hariharanboss/VEGA-Sentinel/images/README.md

# images/

Real photographs and diagrams of the project.

| Folder | Intended contents |
|---|---|
| `prototype/` | photos of the wired ARIES v2.0 build (sensors, divider, buzzer driver) |
| `architecture/` | rendered system/architecture diagrams |
| `testing/` | photos/videos-stills of trials (controlled, supervised flame tests etc.) |

**No images are committed yet** — add real photos here; do not commit
placeholder or stock images. Mermaid diagrams in README.md/docs render on
GitHub and are the current architecture visuals.
