hariharanboss/VEGA-Sentinel/docs/report/vega_sentinel_flame_incident.pdf

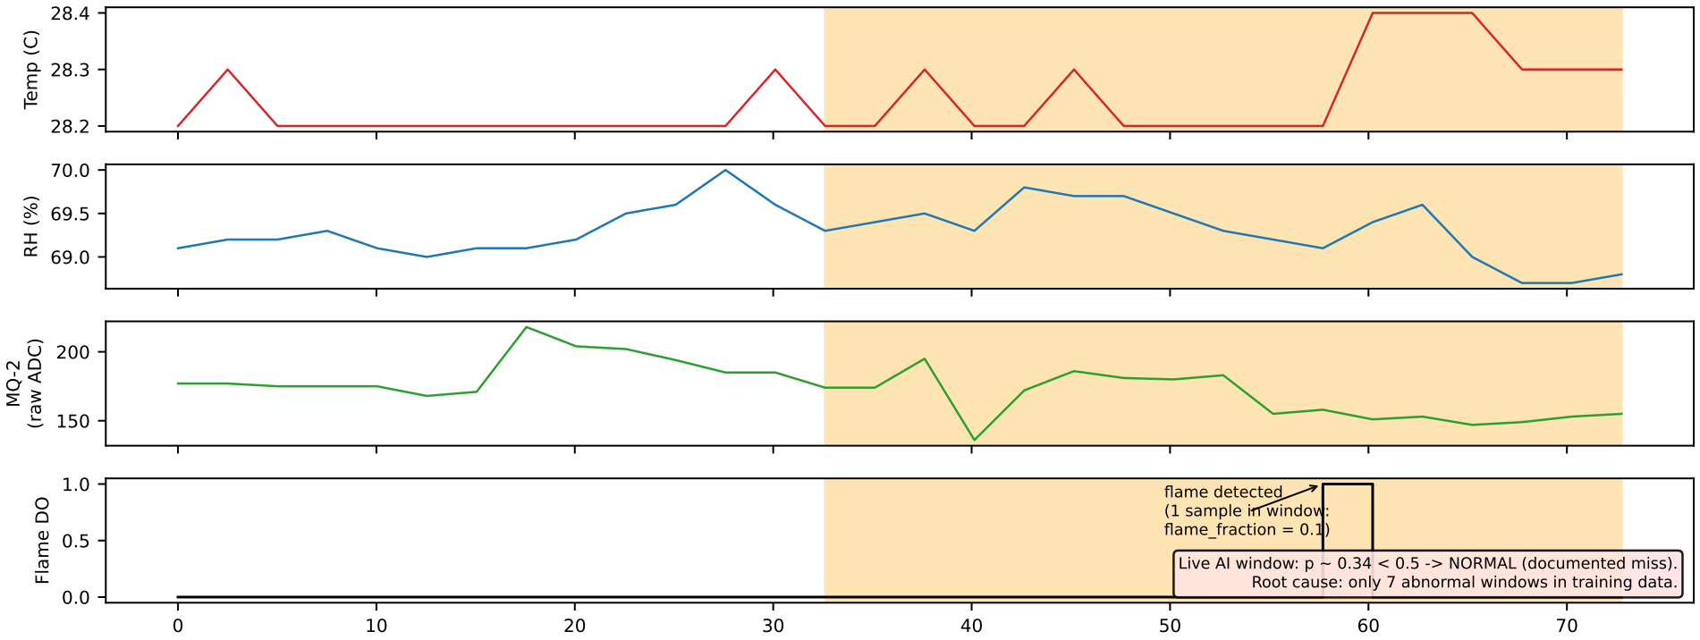
[picture p1: figure]
Temp (C); (raw ADC); Flame DO; flame detected; (1 sample in window: flame_fraction = 0.1)

## Time since session start (s)

Live AI window: p ~ 0.34 < 0.5 -> NORMAL (documented miss). Root cause: only 7 abnormal windows in training data.

## Flame trial 2026-09-11 19:03 (session sentinel_data_20260911_190322)
