hariharanboss/VEGA-Sentinel/docs/report/vega_sentinel_flame_incident.png

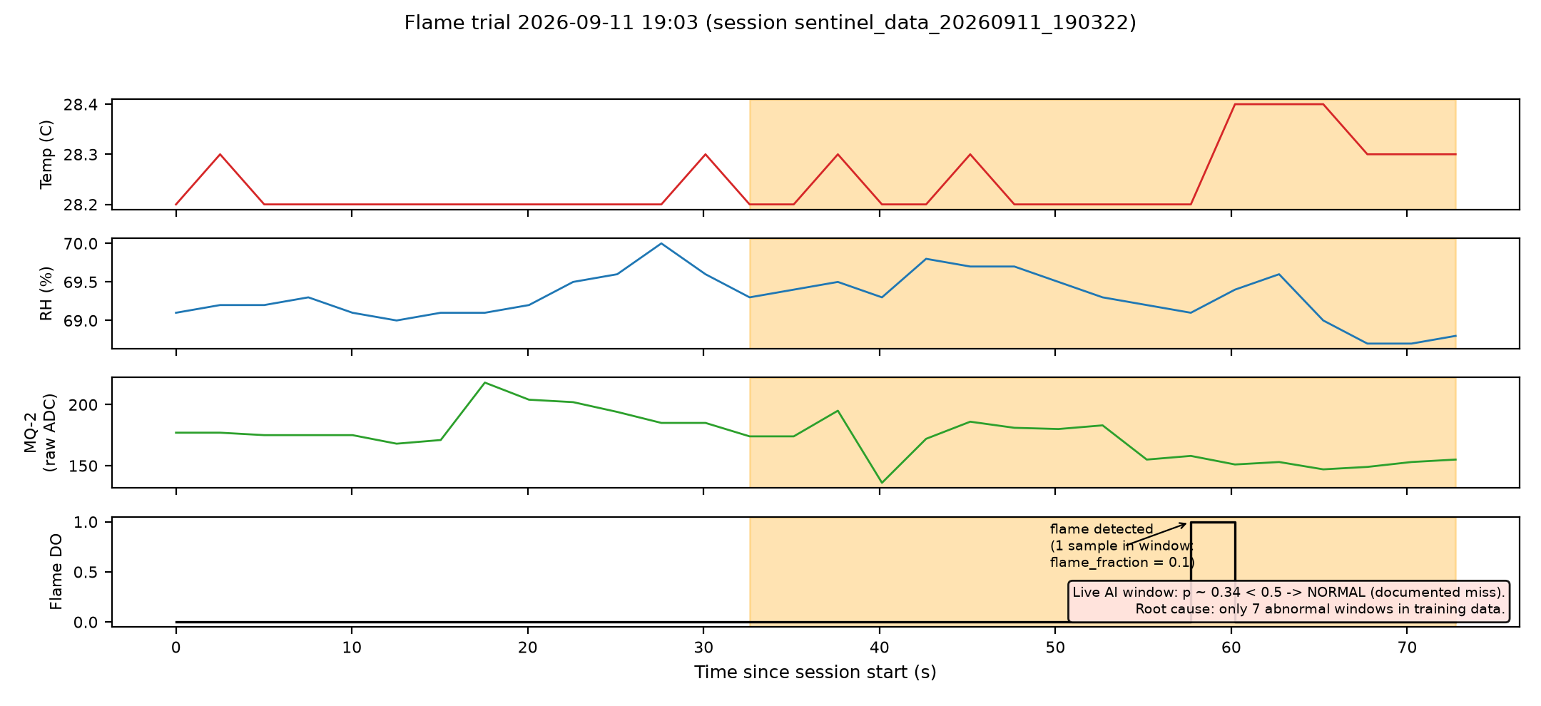
docs/report/vega_sentinel_flame_incident.png
