hariharanboss/VEGA-Sentinel/docs/report/vega_sentinel_mq2_comparison.png

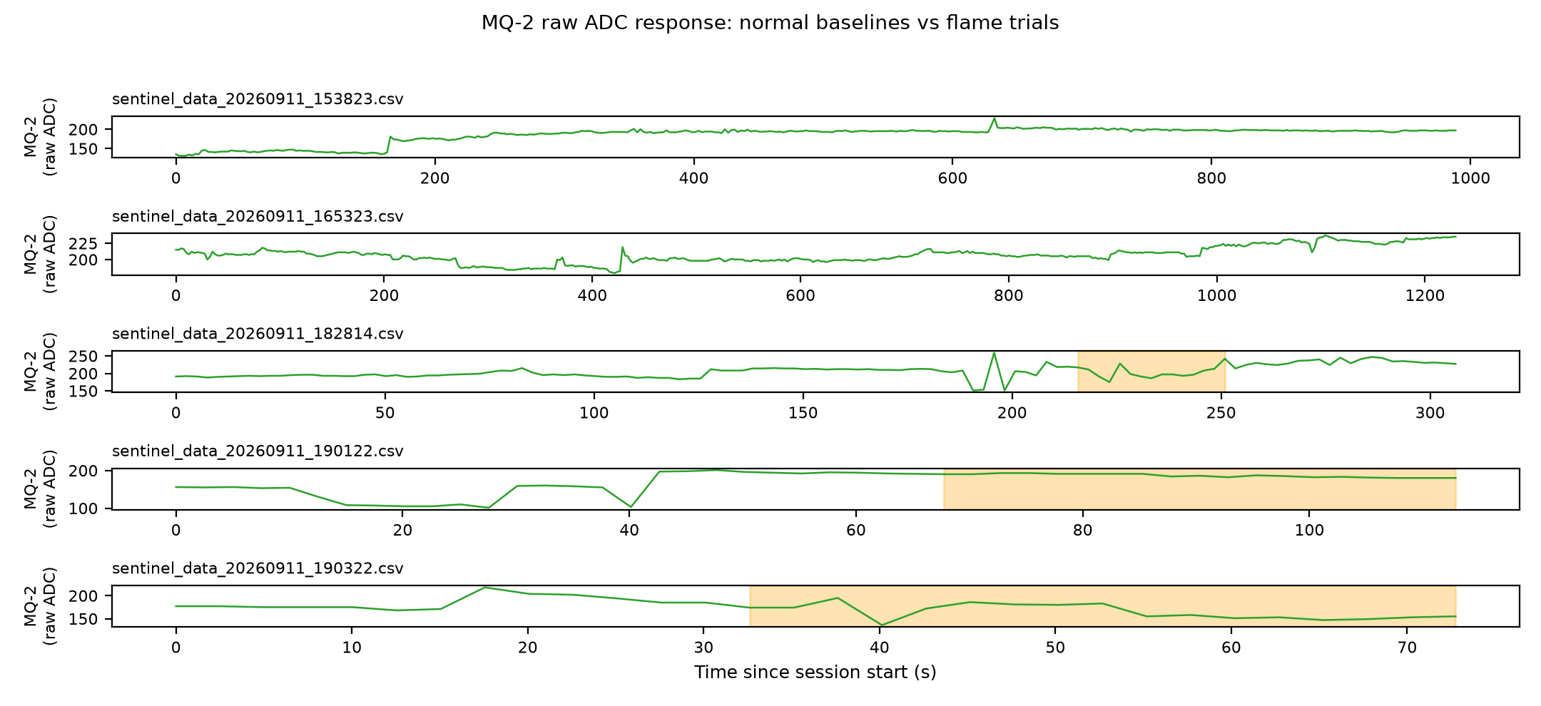
docs/report/vega_sentinel_mq2_comparison.png
