hariharanboss/VEGA-Sentinel/results/model_results/sentinel_anomaly_results_v1.csv

source_file | window_number | mq2_last | temp_last | humidity_last | flame_last | mq2_mean | mq2_std | mq2_min | mq2_max | mq2_range | mq2_delta | mq2_slope_per_s | temp_mean | temp_std | temp_delta | temp_slope_per_s | humidity_mean | humidity_std | humidity_delta | humidity_slope_per_s | flame_count | flame_fraction | critical_count | label | anomaly_label | phase | window_duration_s | anomaly_score | prediction
sentinel_data_20260911_153823.csv | 0 | 146 | 28.8 | 74.9 | 0 | 135.6 | 5.257375771237967 | 131 | 146 | 15 | 11 | 0.555654781228637 | 28.75 | 0.0500000000000007 | 0.0 | -0.0007246604218677 | 74.99 | 0.069999999999996 | -0.0999999999999943 | -0.0065228682805388 | 0 | 0.0 | 0 | normal | 0 | unknown | 22.578000000000003 | 3.7183093201043667 | 0
sentinel_data_20260911_153823.csv | 1 | 143 | 28.7 | 74.9 | 0 | 142.1 | 1.445683229480096 | 140 | 145 | 5 | 2 | 0.1618620194469045 | 28.71 | 0.053851648071345 | 0.0 | -0.0026574027951721 | 74.78 | 0.0871779788708153 | 0.0 | 0.0019326250625802 | 0 | 0.0 | 0 | normal | 0 | unknown | 22.578000000000003 | 3.3954203437152004 | 0
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
