hariharanboss/VEGA-Sentinel/results/graphs/sentinel_data_20260911_182814.png

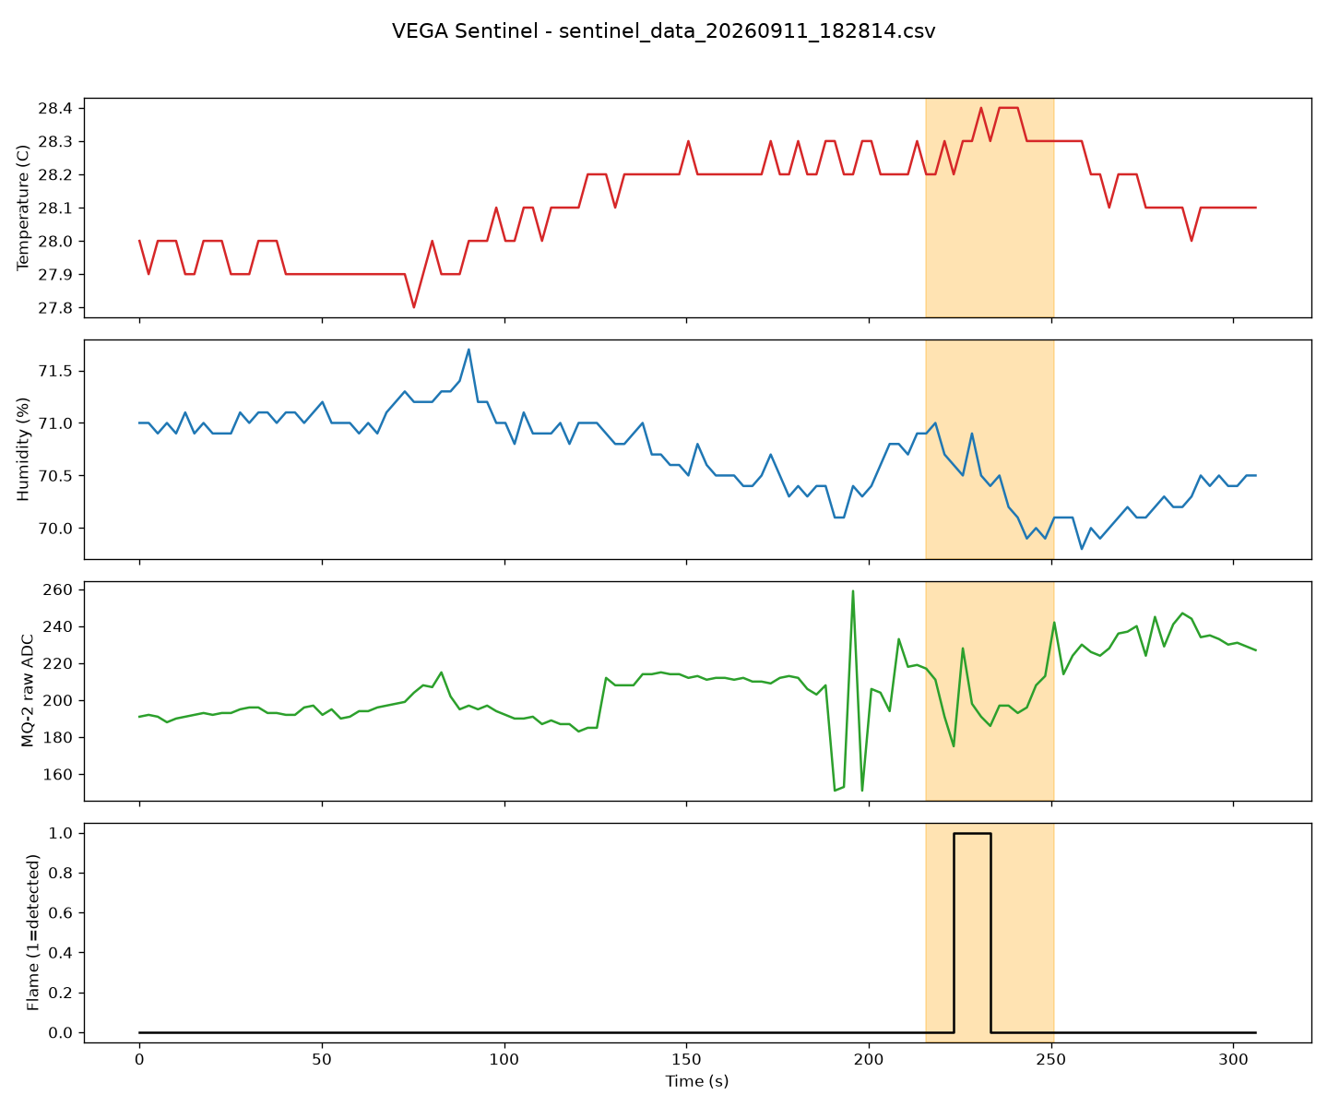
results/graphs/sentinel_data_20260911_182814.png
