hariharanboss/VEGA-Sentinel/docs/report/vega_sentinel_mq2_comparison.pdf

### MQ-2 raw ADC response: normal baselines vs flame trials

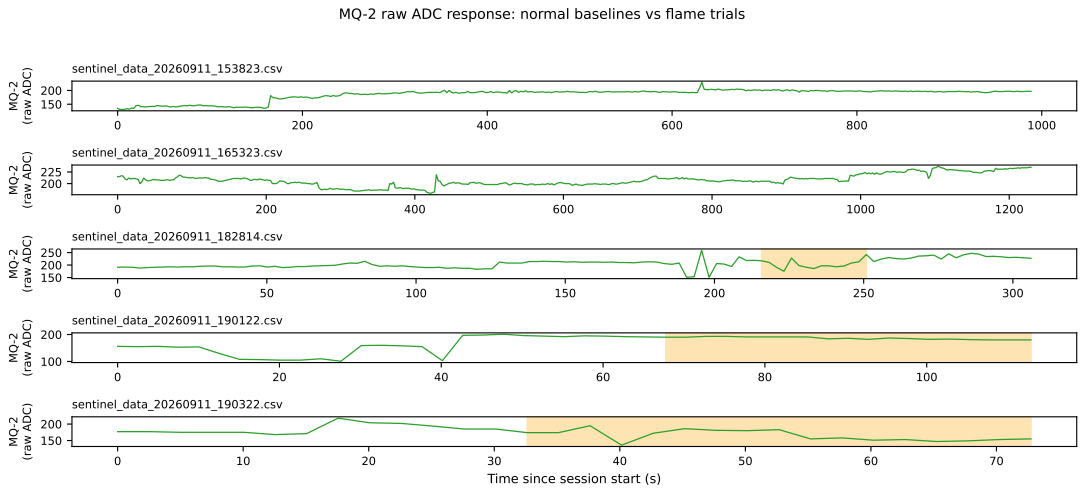
[picture p9: page 1]
(raw ADC); sentinel_data_20260911_153823.csv; sentinel_data_20260911_165323.csv; sentinel_data_20260911_182814.csv; sentinel_data_20260911_190122.csv; sentinel_data_20260911_190322.csv

Time since session start (s)
