hariharanboss/VEGA-Sentinel/(commit log)

2026-09-11 Initialize VEGA Sentinel repository
    Project skeleton, MIT license, requirements, README with verified
    project documentation (VEGA ARIES v2.0, EMBRIX'26 VEGATHON Track 2).
2026-09-11 Add ARIES v2.0 board and sensor bring-up firmware
    Board tests: hello world, RGB LED, ADS1015 ADC, onboard demo.
    Sensor tests: MQ-2 raw read via divider, bit-banged DHT22 driver,
    combined 2.5 s multi-sensor acquisition. All physically verified.
2026-09-11 Add on-board CSV data logger for dataset collection
    Serial CSV rows (2.5 s cadence) consumed by the PC-side dataset logger.
2026-09-11 Add sensor datasets: 5 raw sessions + processed window features
    Raw: 2 normal baselines (~16.5/~20.5 min) + 3 flame-trial sessions.
    Processed: v3 window dataset (107 windows: 100 normal / 7 abnormal) +
    development archives. Honest provenance documented in dataset/README.md.
    [archive_sentinel_window_features_v1.csv, archive_sentinel_window_features_v2.csv, sample_session.csv, sentinel_data_20260911_153823.csv, sentinel_data_20260911_165323.csv, sentinel_data_20260911_182814.csv, sentinel_data_20260911_190122.csv, sentinel_data_20260911_190322.csv]
2026-09-11 Add final firmware: sliding-window Edge-AI + safety confirmation
    Full pipeline on ARIES v2.0: acquire -> validate -> 10-sample window ->
    7 features -> Model A inference -> 2-consecutive-abnormal buzzer logic.
    Includes the DHT-failure fix: window is NOT shifted on invalid samples.
    model.h auto-generated from the training pipeline.
    [model_a_aries_test.ino, sentinel_final.ino]
2026-09-11 Add hardware documentation: BOM, wiring, schematics
    Verified ARIES v2.0 connections, MQ-2 divider design math, 2N2222
    buzzer driver design math.
2026-09-11 Add project documentation and experiment results
    MASTER_CONTEXT.md: complete preserved project context. docs/: overview,
    architecture, hardware, wiring, dataset methodology, TinyML model,
    testing, execution plan. results/: flame-trial record incl. the
    documented missed-detection case and reproducible model figures.
    [sentinel_anomaly_results_v1.csv]
2026-09-11 Add firmware README: bring-up order and verified board facts
2026-09-12 Add LaTeX project report (EMBRIX'26 template structure, Overleaf-ready)
    Fills the official sample-report template with verified project facts:
    model constants, CV 0.9446 / LOTO 0.7449, reference probabilities,
    flame-trial miss documented honestly. Compiles with pdfLaTeX/XeTeX
    (tectonic-verified, 14 pages). Real analysis graphs embedded; remaining
    photo slots render as labeled placeholder boxes.
